nutcasev15/Research-Motor-Tests-2025/pcb/FireSide/FireSide step files/RYLR993_Lite.stp

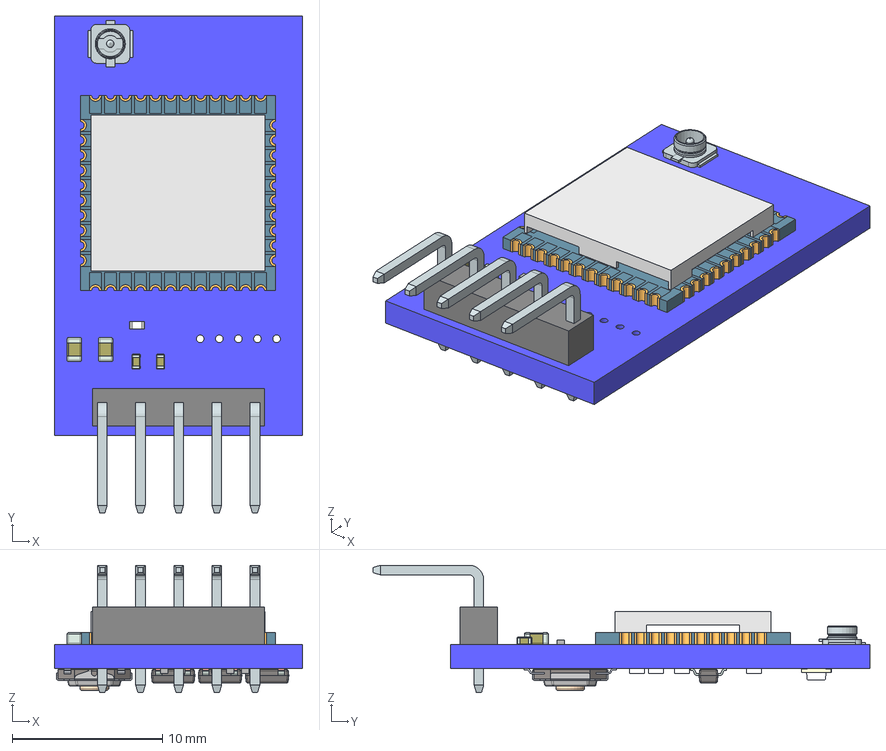
[picture p1: CAD file, 2026-02-07]
pcb/FireSide/FireSide step files/RYLR993_Lite.stp
16.5 x 33.1 x 8.48 mm
