nutcasev15/Research-Motor-Tests-2025/pcb/FireSide/FireSide step files/TerminalBlock2.step

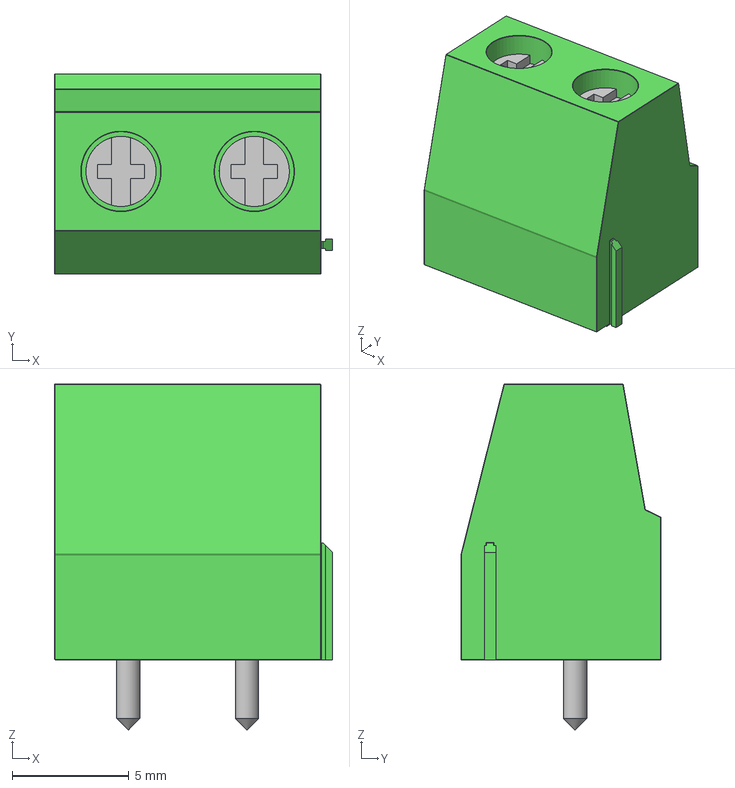
[picture p2: CAD file, 2025-09-08]
pcb/FireSide/FireSide step files/TerminalBlock2.step
11.9 x 8.56 x 14.8 mm
