nutcasev15/Research-Motor-Tests-2025/pcb/FireSide/FireSide step files/D4184.step

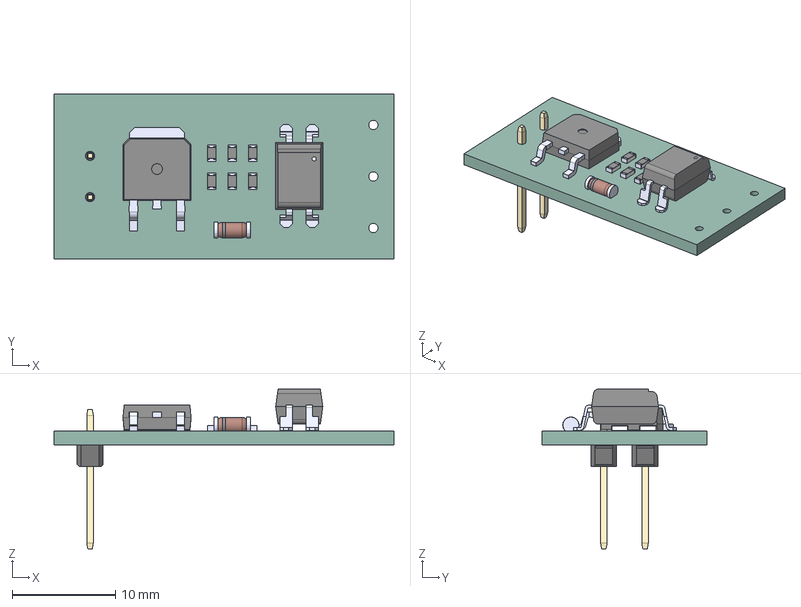
[picture p3: CAD file, 2025-09-08]
pcb/FireSide/FireSide step files/D4184.step
33.0 x 16.0 x 15.5 mm
AOD4184A
PC817X2NIP0F
RC0603JR-070RL x 6
ZMM5231B-7
1x1 Male Pin Header x 2
