nutcasev15/Research-Motor-Tests-2025/pcb/FireSide/FireSide step files/Terminal_Block_3.step

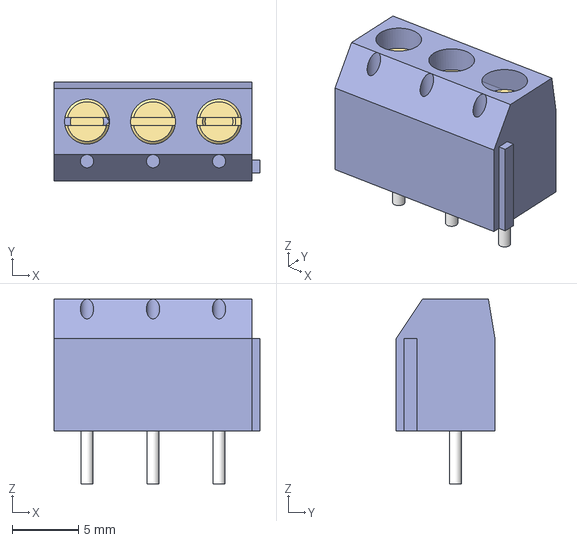
[picture p5: CAD file, 2025-09-08]
pcb/FireSide/FireSide step files/Terminal_Block_3.step
15.6 x 7.50 x 14.0 mm
