nutcasev15/Research-Motor-Tests-2025/pcb/FireSide/FireSide step files/XT60-M.step

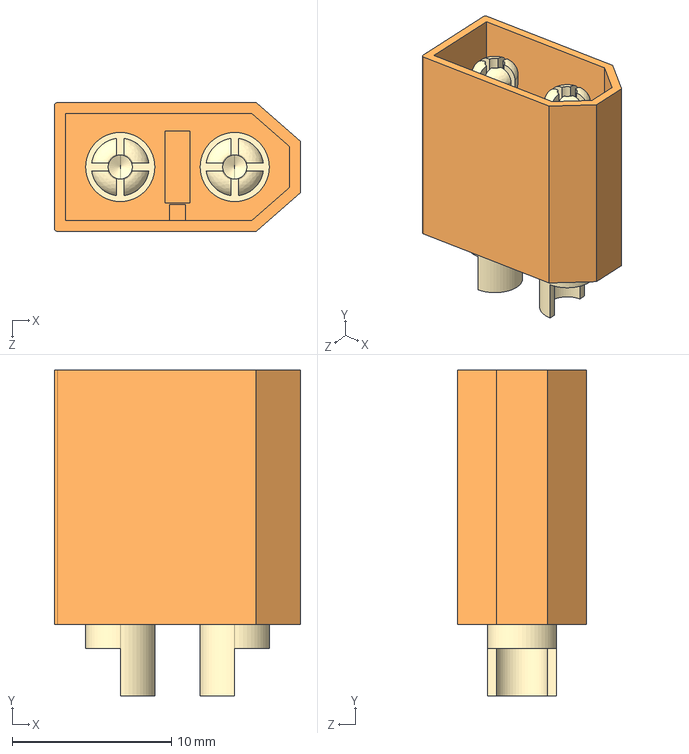
[picture p6: CAD file, 2025-08-28]
pcb/FireSide/FireSide step files/XT60-M.step
15.5 x 20.5 x 8.10 mm
