nutcasev15/Research-Motor-Tests-2025/pcb/FireSide/FireSide.kicad_pcb

## KiCad design pcb/FireSide/FireSide.kicad_pcb (2026-02-22)

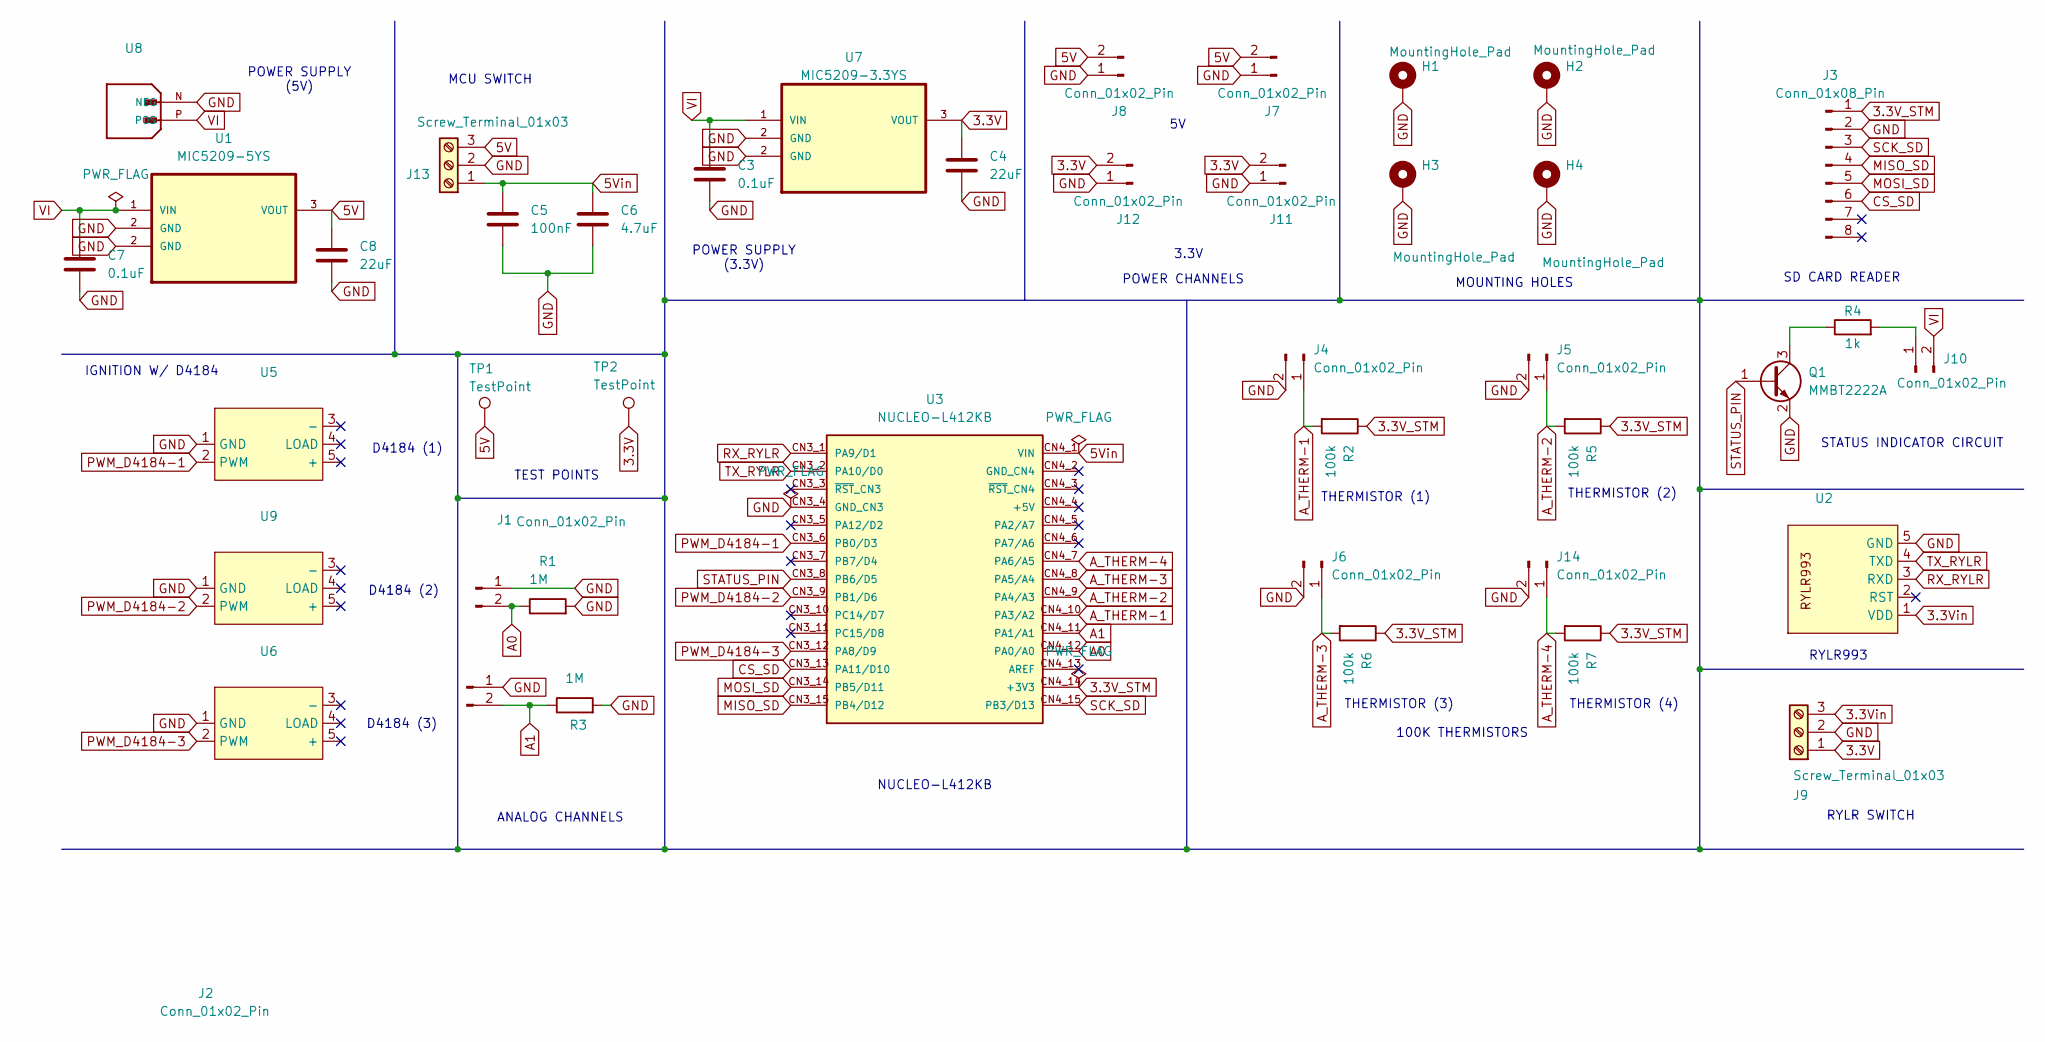
[picture p7: schematic FireSide.kicad_sch, FireSide v2.0]

Parts:
C3, C7: 0.1uF; C_0805_2012Metric
C4, C8: 22uF; C_0805_2012Metric
C5: 100nF; C_0805_2012Metric
C6: 4.7uF; C_0805_2012Metric
H1, H2, H3, H4: MountingHole_Pad; MountingHole_4.3mm_M4_DIN965_Pad
J1, J2, J4, J5, J6, J7, J8, J10, J11, J12, J14: Conn_01x02_Pin; JST_XH_B2B-XH-A_1x02_P2.50mm_Vertical
J3: Conn_01x08_Pin; PinHeader_1x08_P2.54mm_Vertical
J9, J13: Screw_Terminal_01x03; TerminalBlock_bornier-3_P5.08mm
Q1: MMBT2222A; SOT-23
R1, R3: 1M; R_Axial_DIN0204_L3.6mm_D1.6mm_P5.08mm_Horizontal
R2, R5, R6, R7: 100k; R_Axial_DIN0204_L3.6mm_D1.6mm_P5.08mm_Horizontal
R4: 1k; R_0805_2012Metric
TP1, TP2: TestPoint; TestPoint_Loop_D2.60mm_Drill1.6mm_Beaded
U1: MIC5209-5YS; SOT230P700X180-4N
U2: RYLR998
U3: NUCLEO-L412KB; PARTREV 8
U5, U6, U9: D4184
U7: MIC5209-3.3YS; SOT-223-3
U8: XT60-M

Connections:
3.3V: C4.1, J9.1, J11.2, J12.2, TP2.1, U7.3 (VOUT)
3.3V_STM: J3.1, R2.1, R5.1, R6.1, R7.1, U3.CN4_14 (+3V3)
3.3Vin: J9.3, U2.1 (VDD)
5V: C8.1, J7.2, J8.2, J13.3, TP1.1, U1.3 (VOUT)
5Vin: C5.1, C6.1, J13.1, U3.CN4_1 (VIN)
A0: J1.2, R1.1, U3.CN4_12 (PA0/A0)
A1: J2.2, R3.1, U3.CN4_11 (PA1/A1)
A_THERM-1: J4.1, R2.2, U3.CN4_10 (PA3/A2)
A_THERM-2: J5.1, R5.2, U3.CN4_9 (PA4/A3)
A_THERM-3: J6.1, R6.2, U3.CN4_8 (PA5/A4)
A_THERM-4: J14.1, R7.2, U3.CN4_7 (PA6/A5)
CS_SD: J3.6, U3.CN3_13 (PA11/D10)
GND: C3.2, C4.2, C5.2, C6.2, C7.2, C8.2, H1.1, H2.1, H3.1, H4.1, J1.1, J2.1, J3.2, J4.2, J5.2, J6.2, J7.1, J8.1, J9.2, J11.1, J12.1, J13.2, J14.2, Q1.2 (E), R1.2, R3.2, U1.2 (GND), U2.5 (GND), U3.CN3_4 (GND_CN3), U5.1 (GND), U6.1 (GND), U7.2 (GND), U8.N (NEG), U9.1 (GND)
MISO_SD: J3.4, U3.CN3_15 (PB4/D12)
MOSI_SD: J3.5, U3.CN3_14 (PB5/D11)
unnamed: J10.1, R4.2
unnamed: Q1.3 (C), R4.1
PWM_D4184-1: U3.CN3_6 (PB0/D3), U5.2 (PWM)
PWM_D4184-2: U3.CN3_9 (PB1/D6), U9.2 (PWM)
PWM_D4184-3: U3.CN3_12 (PA8/D9), U6.2 (PWM)
RX_RYLR: U2.3 (RXD), U3.CN3_1 (PA9/D1)
SCK_SD: J3.3, U3.CN4_15 (PB3/D13)
STATUS_PIN: Q1.1 (B), U3.CN3_8 (PB6/D5)
TX_RYLR: U2.4 (TXD), U3.CN3_2 (PA10/D0)
VI: C3.1, C7.1, J10.2, U1.1 (VIN), U7.1 (VIN), U8.P (POS)

Notes on the sheet:
D4184 (3)
RYLR993
THERMISTOR (4)
THERMISTOR (1)
IGNITION W/ D4184
SD CARD READER
STATUS INDICATOR CIRCUIT
THERMISTOR (3)
3.3V
THERMISTOR (2)
POWER SUPPLY (5V)
NUCLEO-L412KB
ANALOG CHANNELS
POWER SUPPLY (3.3V)
POWER CHANNELS
RYLR SWITCH
100K THERMISTORS
TEST POINTS
MOUNTING HOLES
D4184 (1)
D4184 (2)
MCU SWITCH

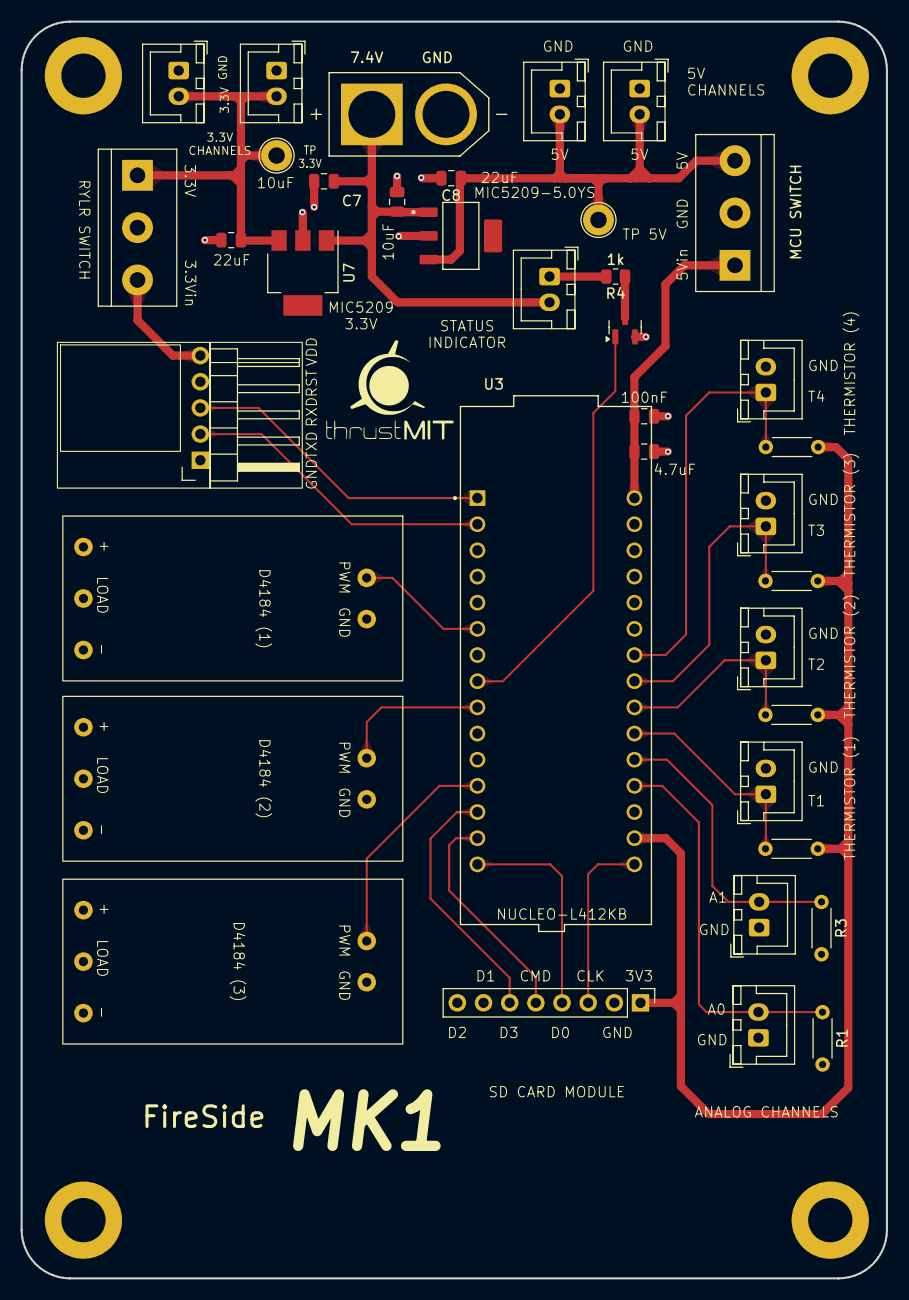
[picture p8: board FireSide.kicad_pcb from above]

Board: 2 copper layers, 84.0 x 122.0 mm, 42 parts (0 on the bottom side), 25 nets.
