nutcasev15/Research-Motor-Tests-2025/(commit log)

2025-03-22 Added current files
2025-03-23 Update groundside.ino
    at line 62, the currentState was still LAUNCH and not DONE, so the switch was never going in DONE case at testbed uno
2025-05-04 [GS] Remove State Machine Implementation in GroundSide UNO Code
2025-05-05 [GS] Remove Prefix in Serial Outputs to Avoid Confusion
    [main.cpp]
2025-05-05 [FS] Shorten Comments in C/C++
    [Interfaces.hpp, States.cpp, States.hpp, main.cpp]
2025-05-05 [FS] Fix SD Not Initialised Bug After Conversion
    [States.cpp]
2025-05-05 [FS] Improve Scope of Failure State Diagnostics
    [States.cpp]
2025-05-05 Optimise String Library Usage for FireSide and GroundSide
2025-05-06 [FS] Create FireSide Board Schematics
    [FireSide.kicad_pcb, FireSide.kicad_sch]
2025-05-06 [FS] Correct Igniter Firing Logic to Inverted Logic
    [Interfaces.hpp, States.cpp]
2025-05-06 [FS] Create PCB Board Design
    [FireSide.kicad_pcb, FireSide.kicad_sch]
2025-05-06 [FS] Fix Unintended Igniter Firing Bug at Startup
    [main.cpp]
2025-05-11 [GS] Fix Malformed AT Send Command Bug
    [main.cpp]
2025-05-11 [FS] Cosmetic Corrections to Python Script Comments
    [ConvertLog.py]
2025-05-11 [FS] Call Return After Call to ErrorBlink Function
    [DMADAQ.cpp, States.cpp]
2025-05-25 [GIT] Ignore KiCAD Editing Lock File
2025-05-25 [FS] Update PCB to 120x80 mm and Use JST Connectors
    [FireSide.kicad_pcb, FireSide.kicad_sch]
2025-07-19 [GS] Transition to Python USB Serial Implementation for GroundSide
2025-07-29 [FS] Correct State Transition and Predicate Implementation
    [States.cpp, States.hpp, main.cpp]
2025-07-29 [FS] Fix OSC-32K and D8 Pin Conflict
    [Interfaces.hpp]
2025-08-03 [FS] Debug Single Shot Analog Pin Readouts and Extend to 7 Pin Logging
2025-08-09 [FS] Correct STM32 HAL Interrupt Callbacks and Peripheral Configuration
    [DMADAQ.cpp, DMADAQ.hpp, Interfaces.hpp]
2025-08-09 [FS] Increase SD Card SPI Clock Rates to 20 MHz
2025-08-09 [FS] Fix Incorrect File Name Check
    [States.cpp]
2025-08-09 [FS] Clean Up Arduino String Manipulation Code for File IO
2025-08-24 [FS] Fix CRLF AT Command Bug in RYLR Interface
    [Interfaces.hpp]
2025-08-24 [FS] Check SD Card State Before ARM Procedure Completion
2025-08-24 [FS] Reduce High Speed Bus Bandwidth and Avoid Resource Conflicts
    [DMADAQ.cpp, Interfaces.hpp]
2025-08-24 [FS] Fix DMA Buffer Overrun and Bus Fault
    [DMADAQ.cpp]
2025-08-24 [FS] Fix Binary Data Readout Misalignment and Timestamp Calculation
    [ConvertLog.py, DMADAQ.cpp]
2025-08-26 [FS] Transition PCB to Nucleo L412KB and SMD Components
    [FireSide.kicad_pcb, FireSide.kicad_sch]
2025-09-23 [FS] Updated PCB files to v2.5
    [D4184.step, FireSide v2.0.kicad_pcb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]
2025-10-05 [FS] PCB Updated to v1.1.6
    [D4184.step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]
2026-01-18 Shift to RYLR993 Default on GroundSide and FireSide
2026-01-18 [FS] Report Debug Data on RYLR Error Instead
    [Interfaces.hpp]
2026-01-18 [FS] Change Polling from STM32 Serial to RYLR Responses
2026-01-18 [FS] Skip RYLR Boot & Response Checks on USB Serial Link
    [Interfaces.hpp, States.cpp]
2026-01-20 Revert "Reduce Latency in RYLR Interfaces to 100ms"
    This reverts commit 39dadd360af1746bcde35fad65637af7eb3f1ce5.
    [Interfaces.hpp, States.cpp]
2026-01-21 [FS] Revert trim in relayer parsing
    [Interfaces.hpp]
2026-02-07 [FS] Updated FireSide PCB with RYLR993
    [FireSide.kicad_pcb, FireSide.kicad_sch, RYLR993_Lite.stp, RYLR998.stp]
2026-02-22 [FS] Updated PCB (v1.2.0)
    [FireSide.kicad_pcb, FireSide.kicad_sch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]
